iandanforth/rSkin/photos/IMG_20110914_180611.jpg

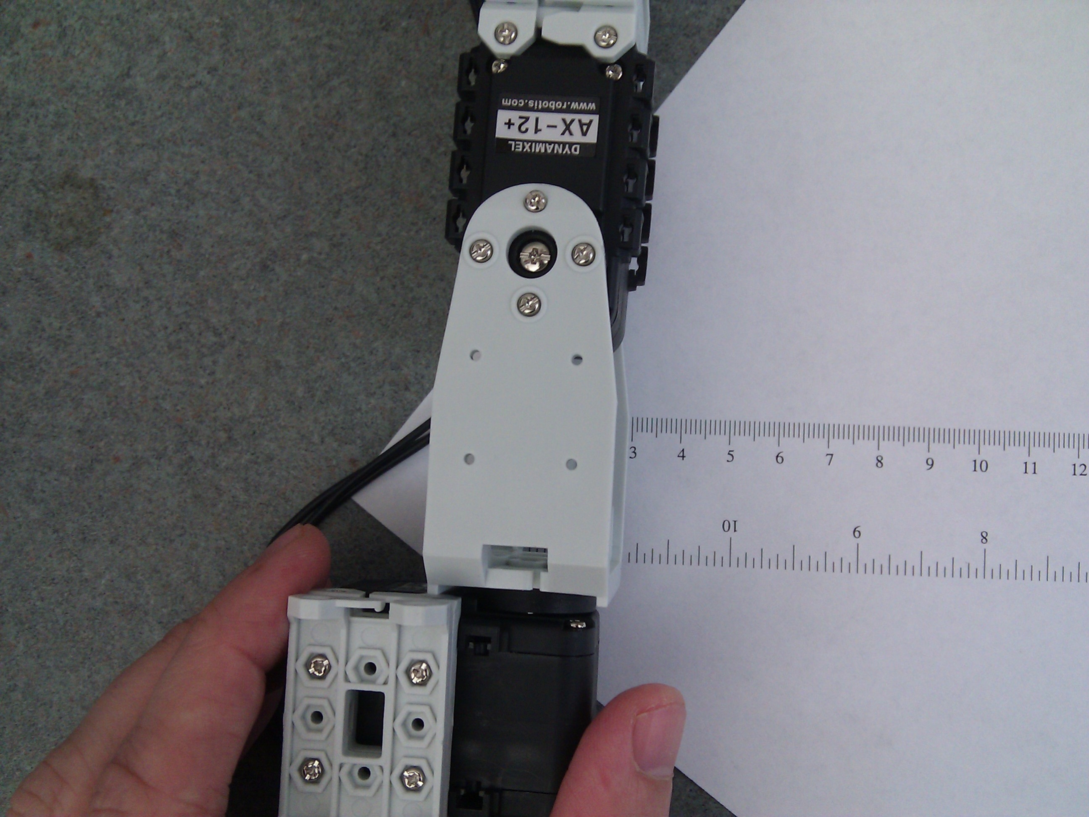
photos/IMG_20110914_180611.jpg
