iandanforth/rSkin/photos/IMG_20110914_180637.jpg

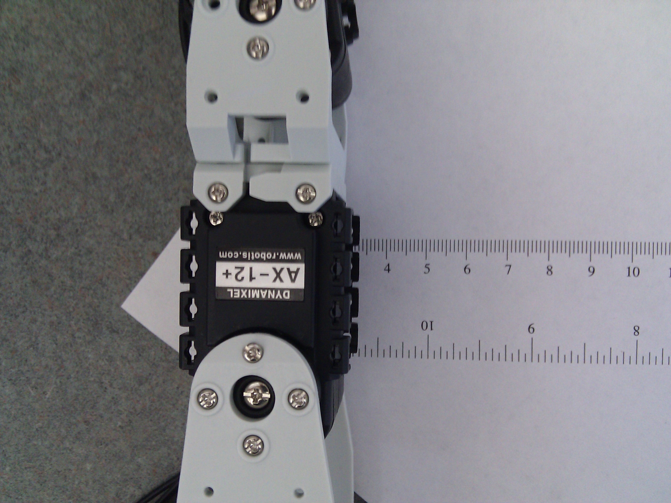
photos/IMG_20110914_180637.jpg
