iandanforth/rSkin/eagle/rSkinBRD.jpg

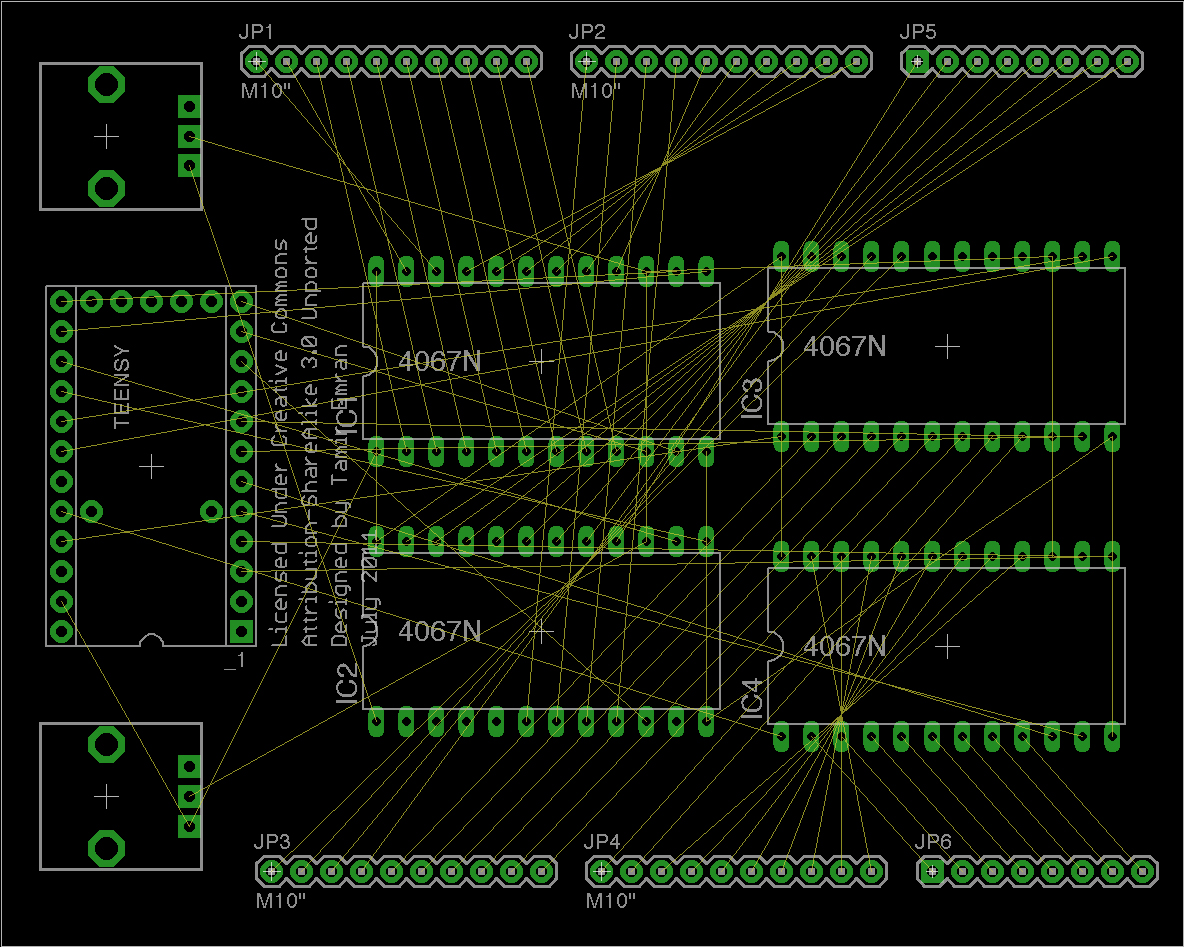
eagle/rSkinBRD.jpg
