iandanforth/rSkin/eagle/rSkinSCH.jpg

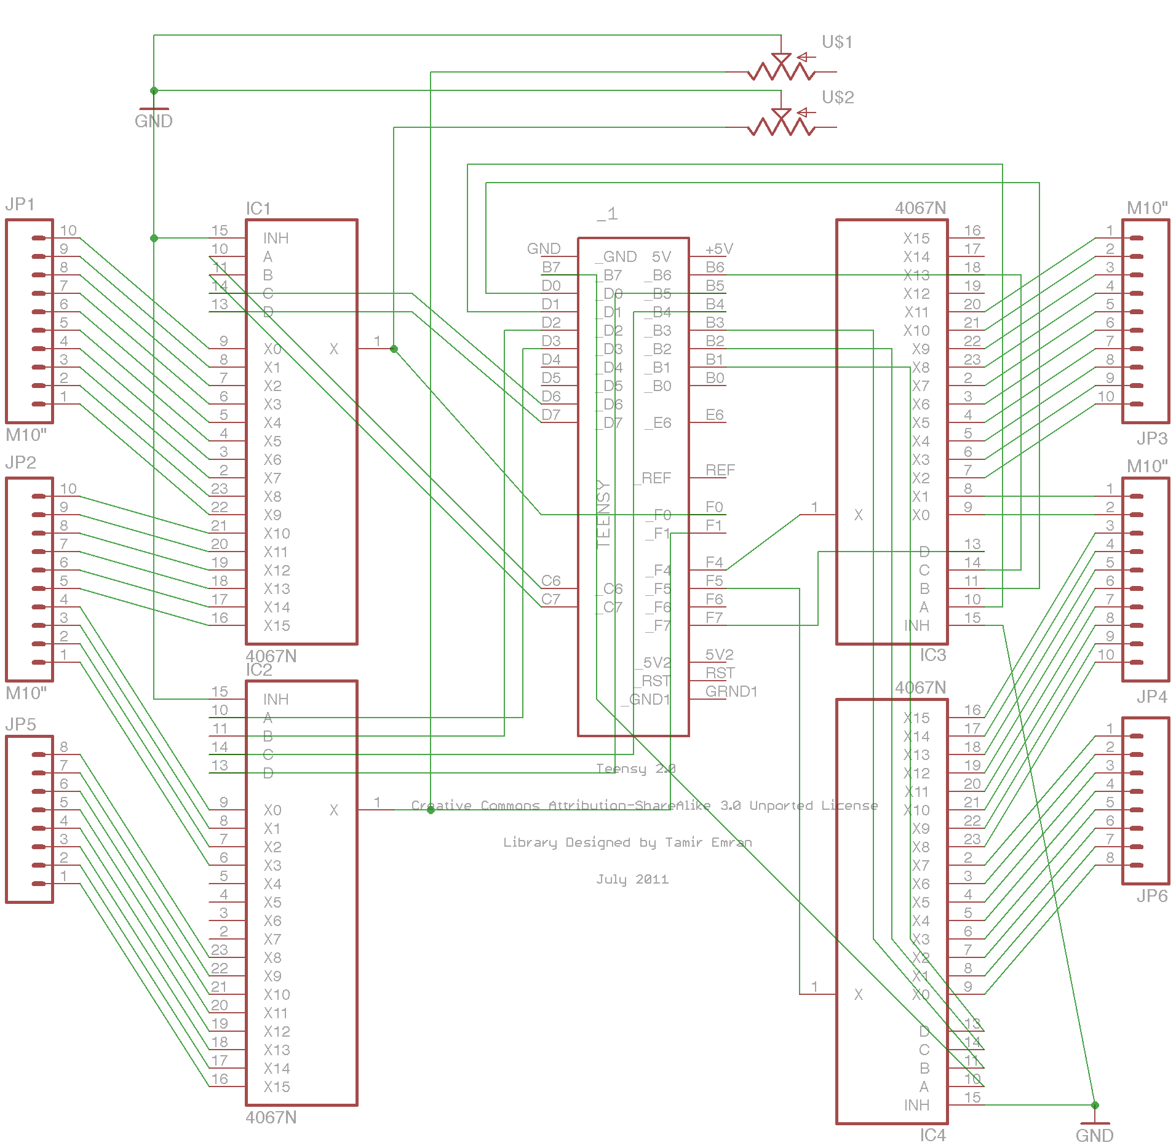
eagle/rSkinSCH.jpg
