iandanforth/rSkin/illustrations/dimensions2.jpg

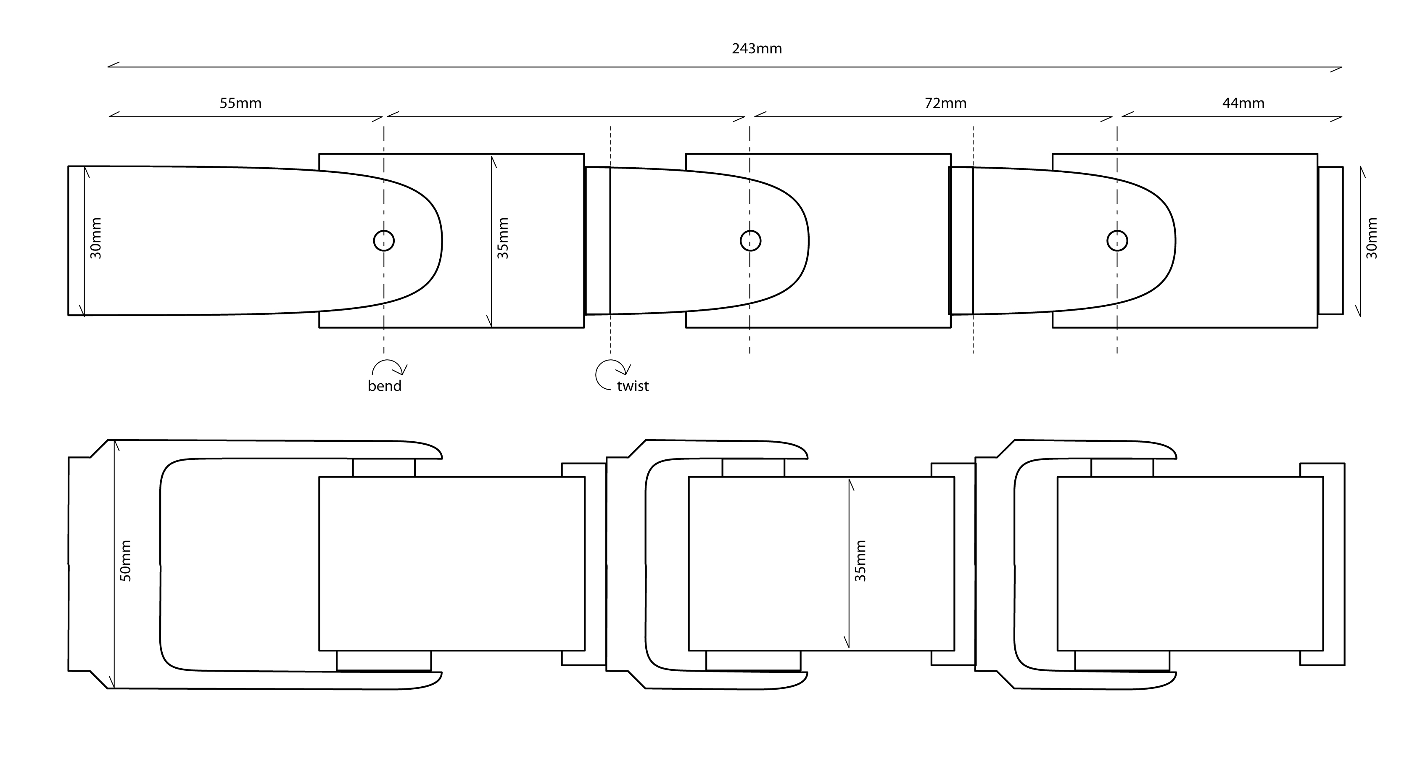
illustrations/dimensions2.jpg
