iandanforth/rSkin/illustrations/dimensions3.jpg

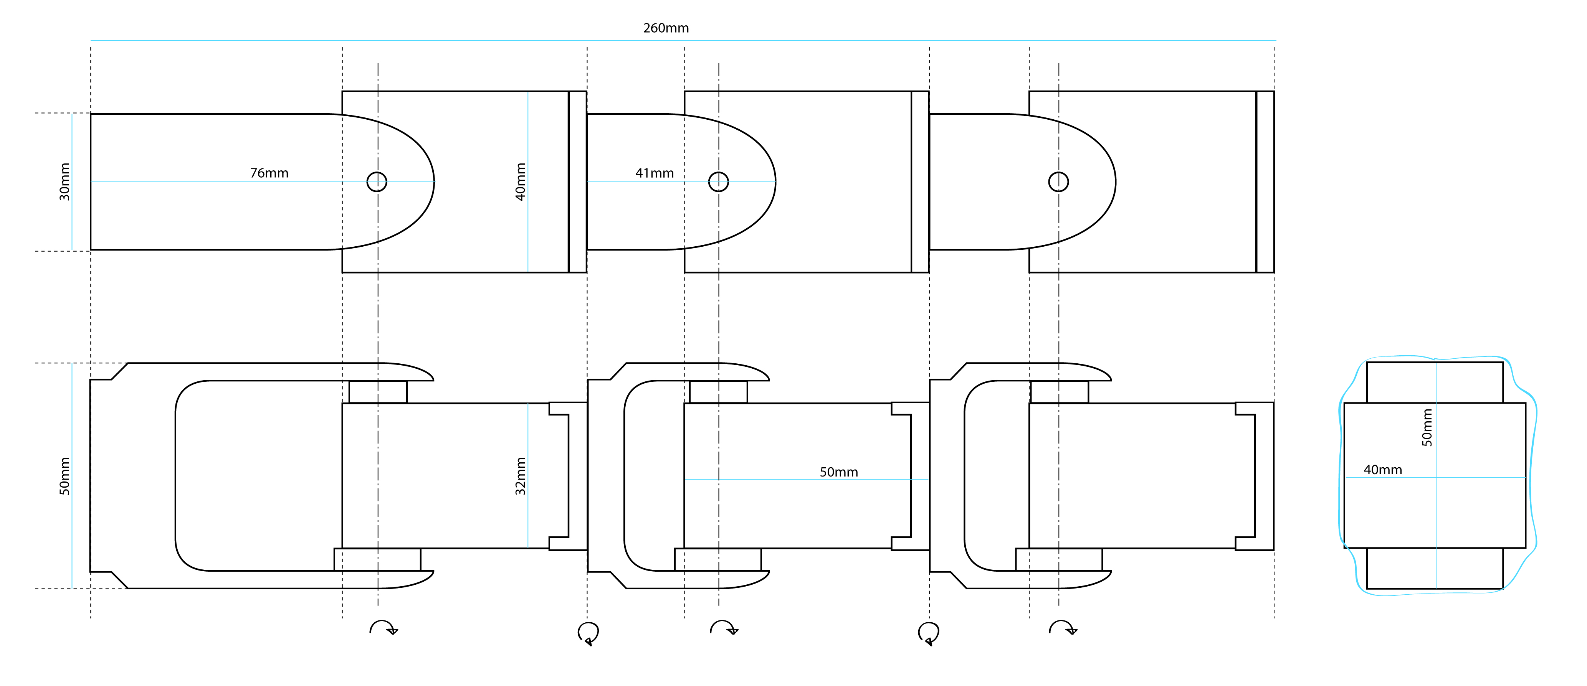
illustrations/dimensions3.jpg
