iandanforth/rSkin/illustrations/dimensions.jpg

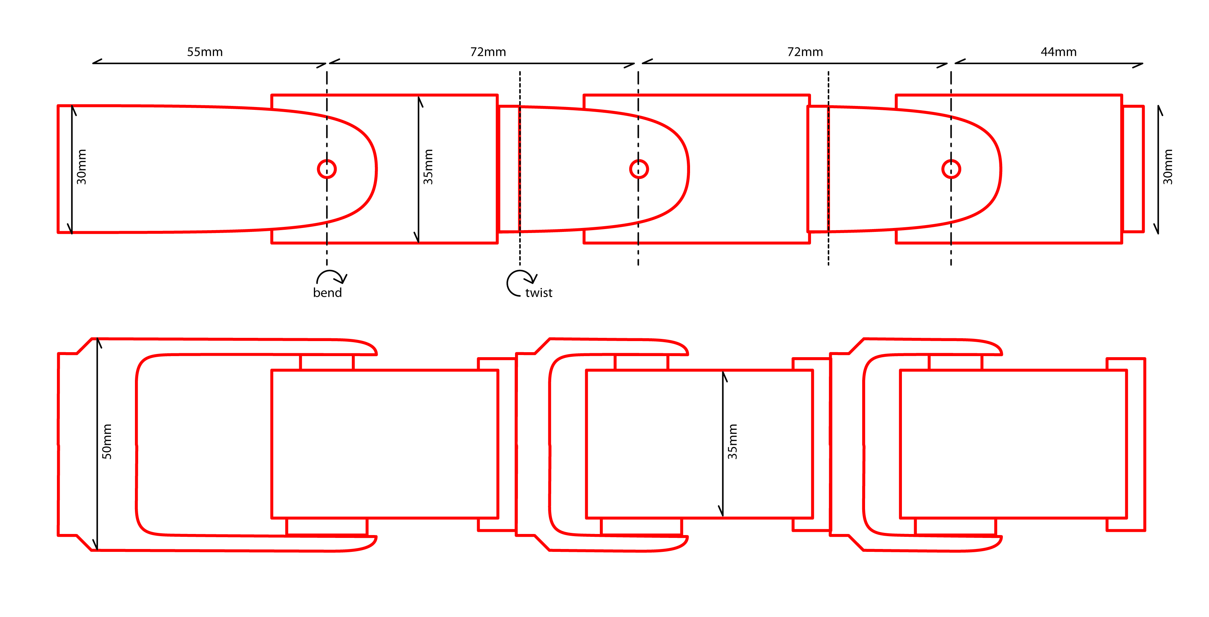
illustrations/dimensions.jpg
