iandanforth/rSkin/illustrations/flesh.jpg

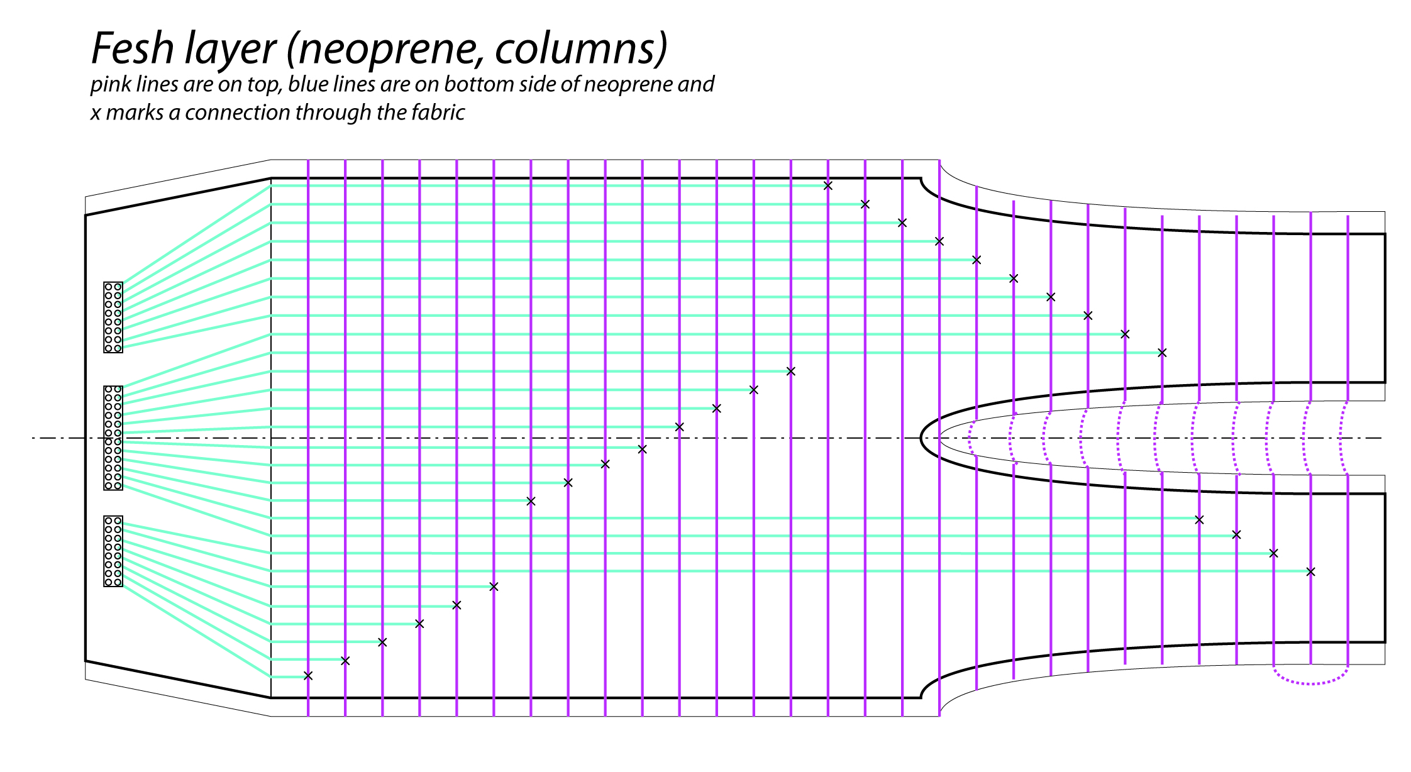
illustrations/flesh.jpg
