iandanforth/rSkin/illustrations/grid.jpg

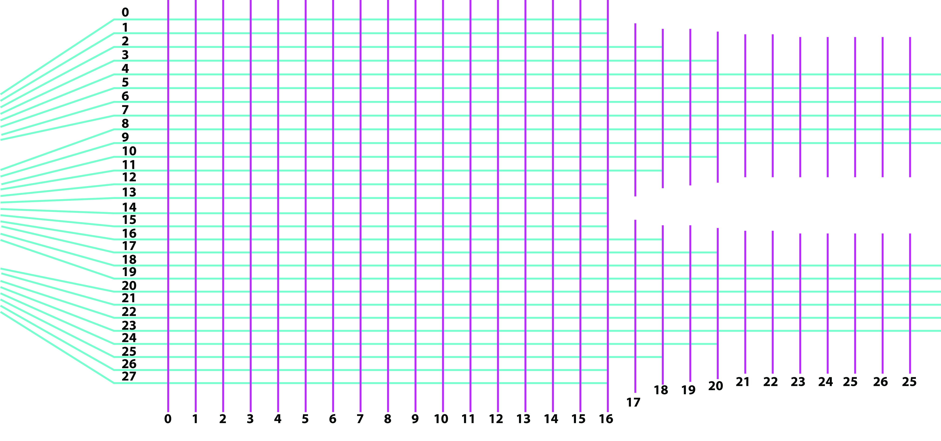
illustrations/grid.jpg
