iandanforth/rSkin/illustrations/laser.jpg

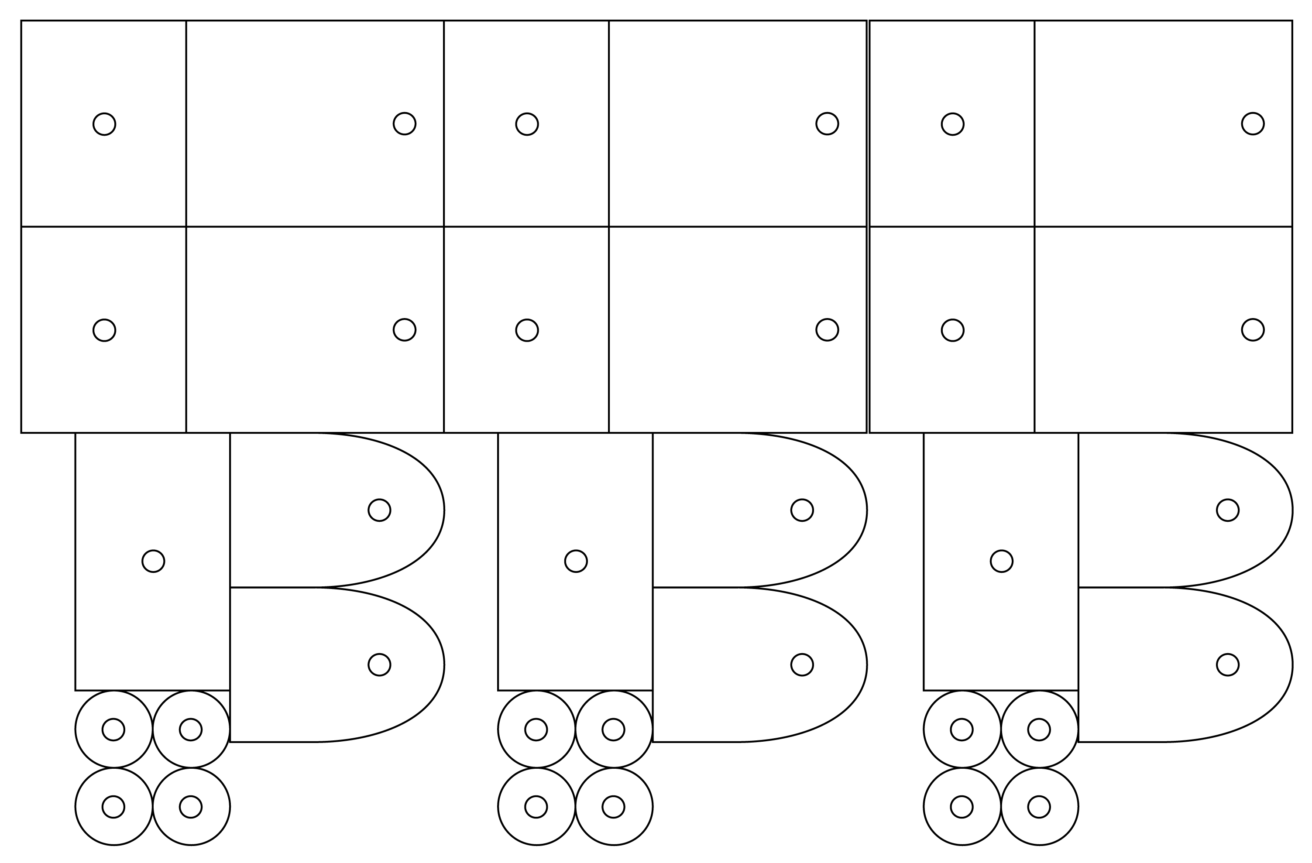
illustrations/laser.jpg
