iandanforth/rSkin/illustrations/layers.jpg

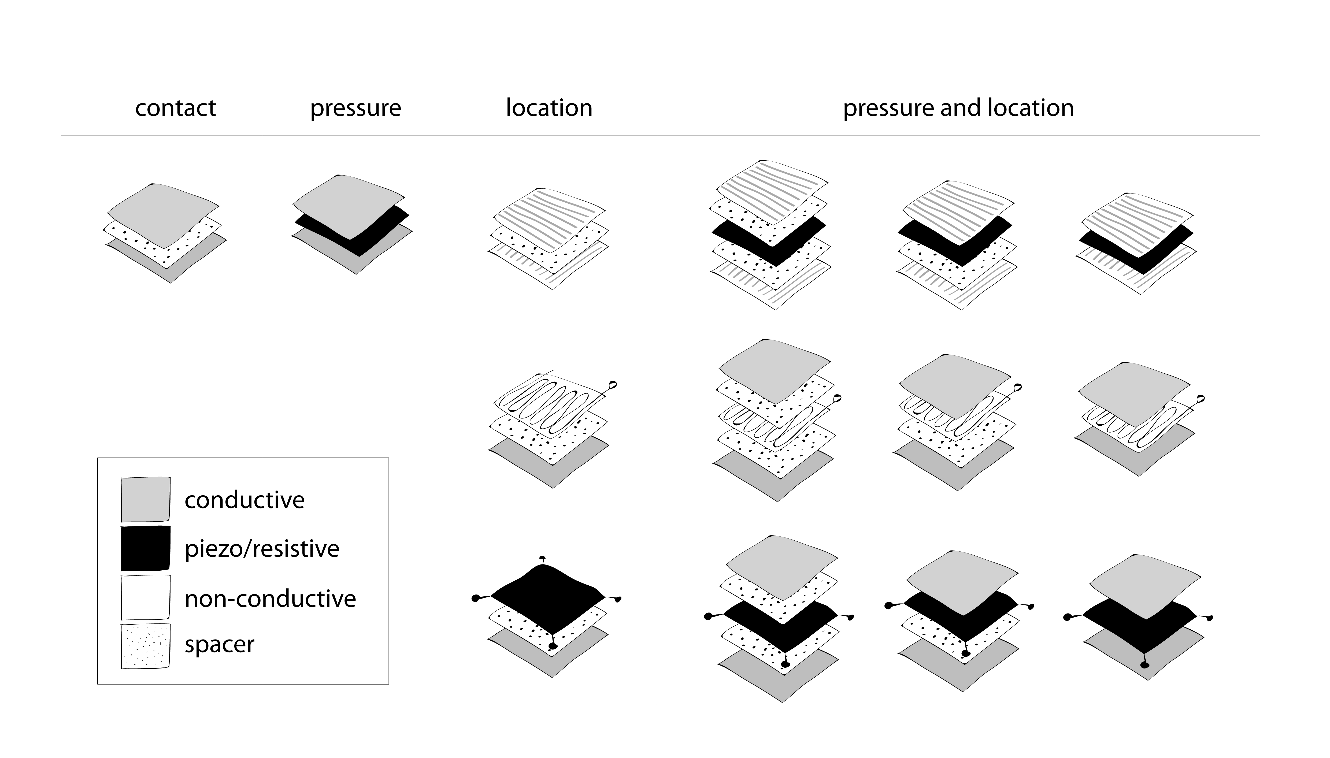
illustrations/layers.jpg
