iandanforth/rSkin/illustrations/resistive-layers.jpg

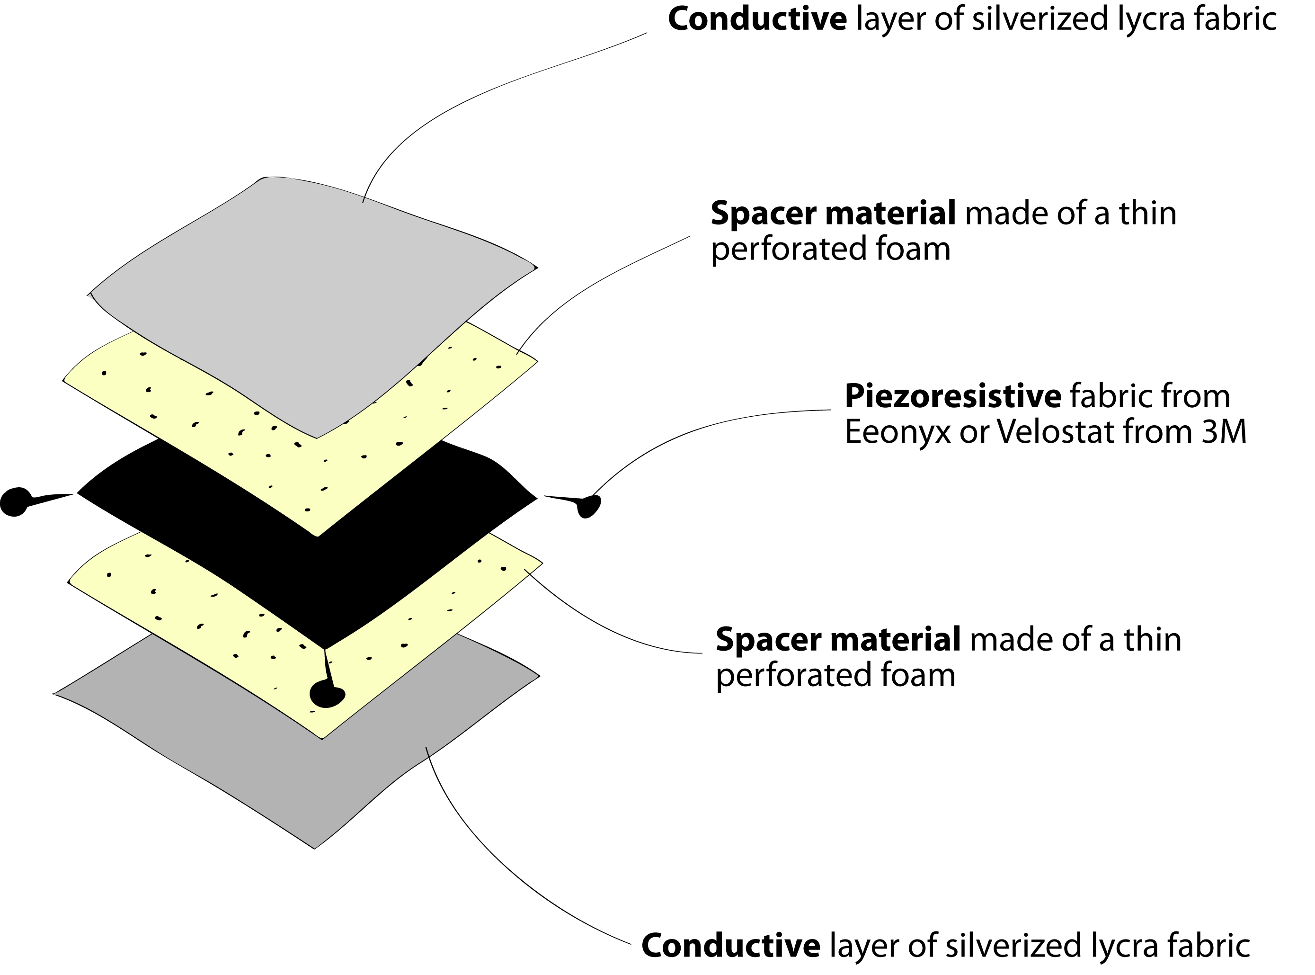
illustrations/resistive-layers.jpg
