iandanforth/rSkin/illustrations/skin.jpg

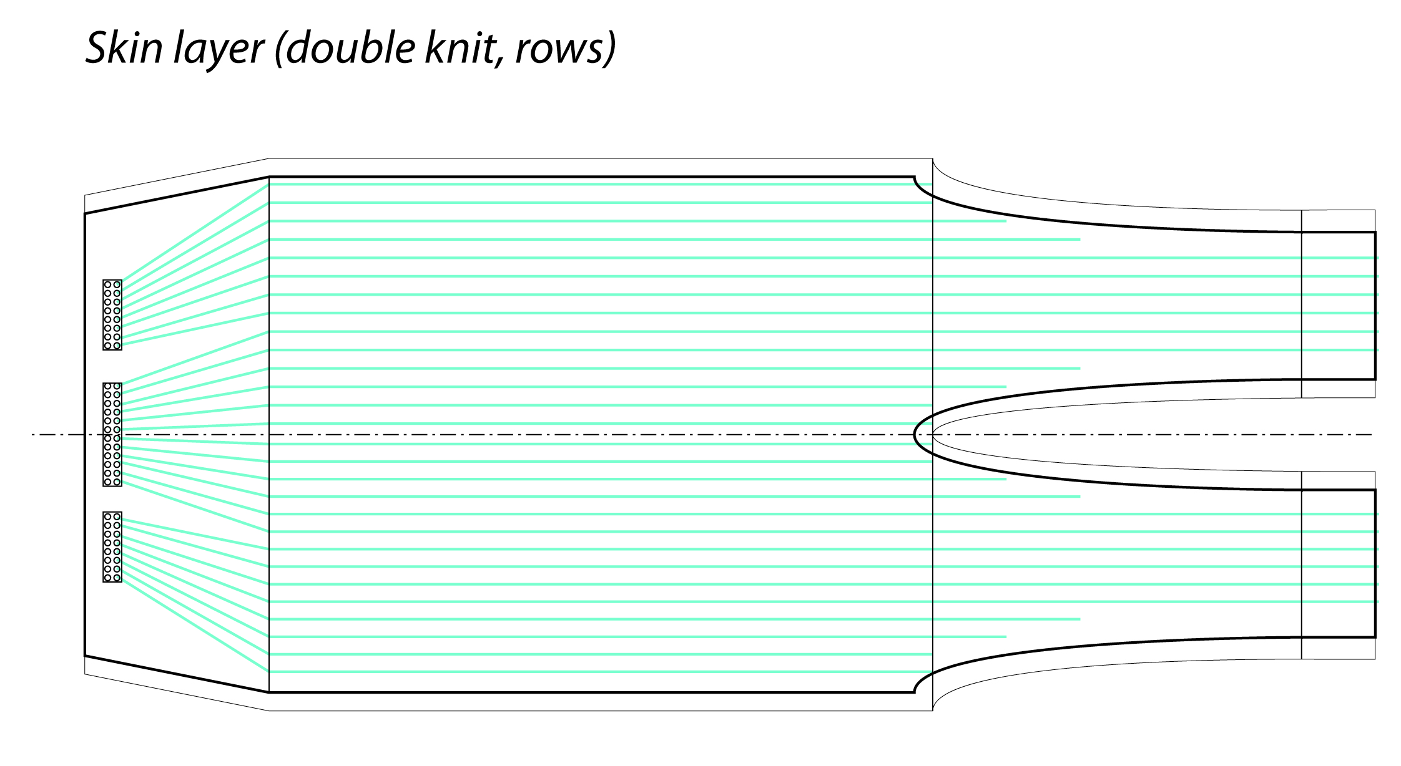
illustrations/skin.jpg
