iandanforth/rSkin/photos/connections.jpg

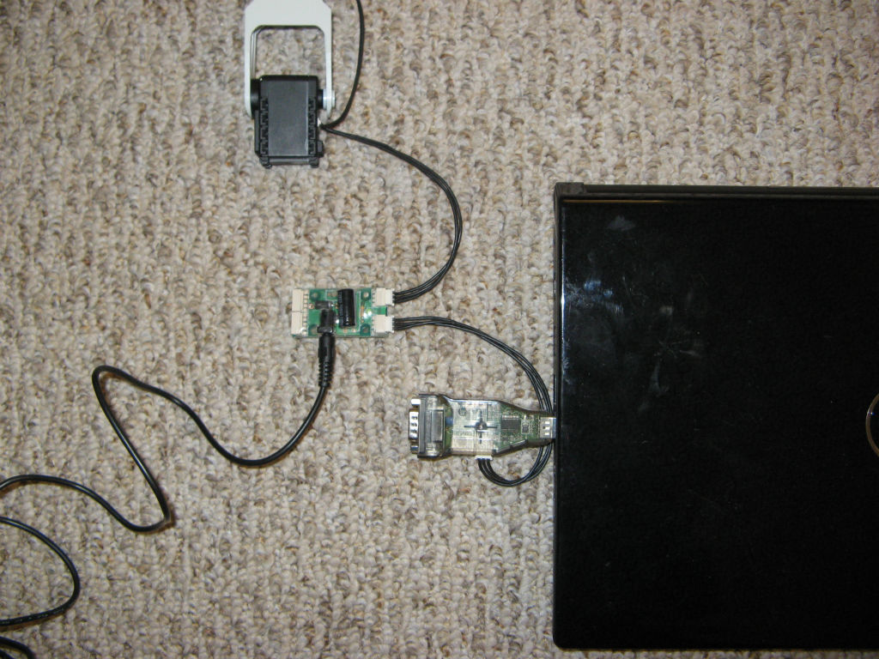
photos/connections.jpg
