iandanforth/rSkin/photos/fixturepoints.png

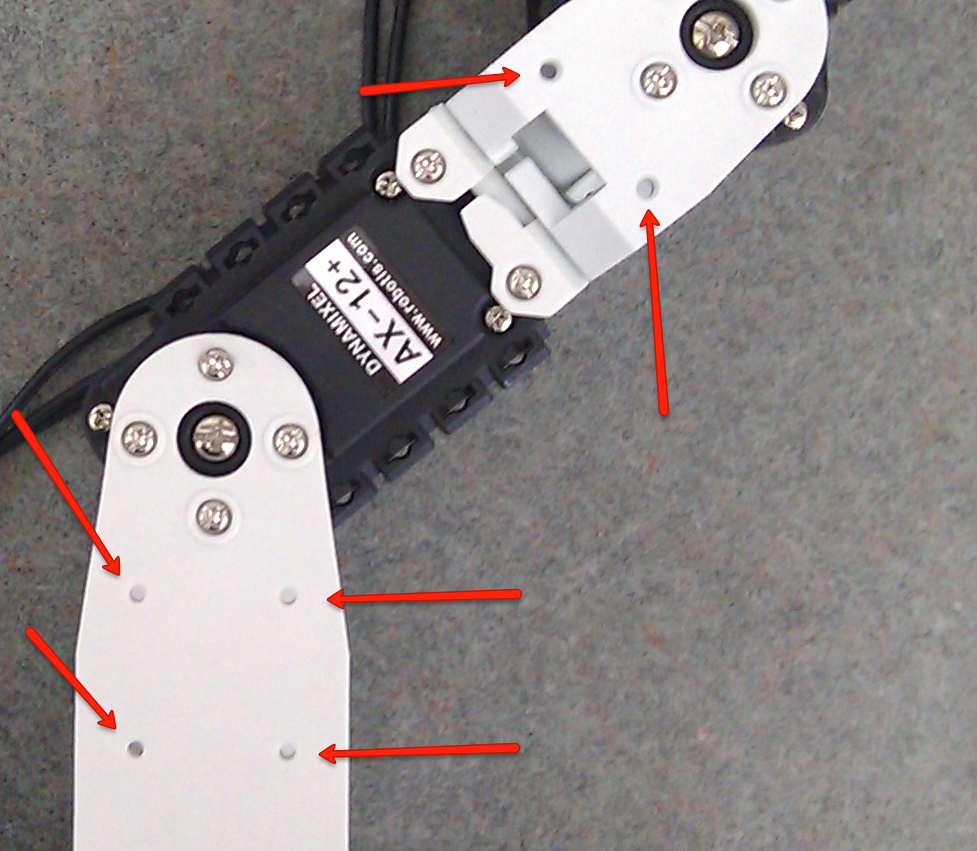
photos/fixturepoints.png
