iandanforth/rSkin/photos/IMG_20110829_172705.jpg

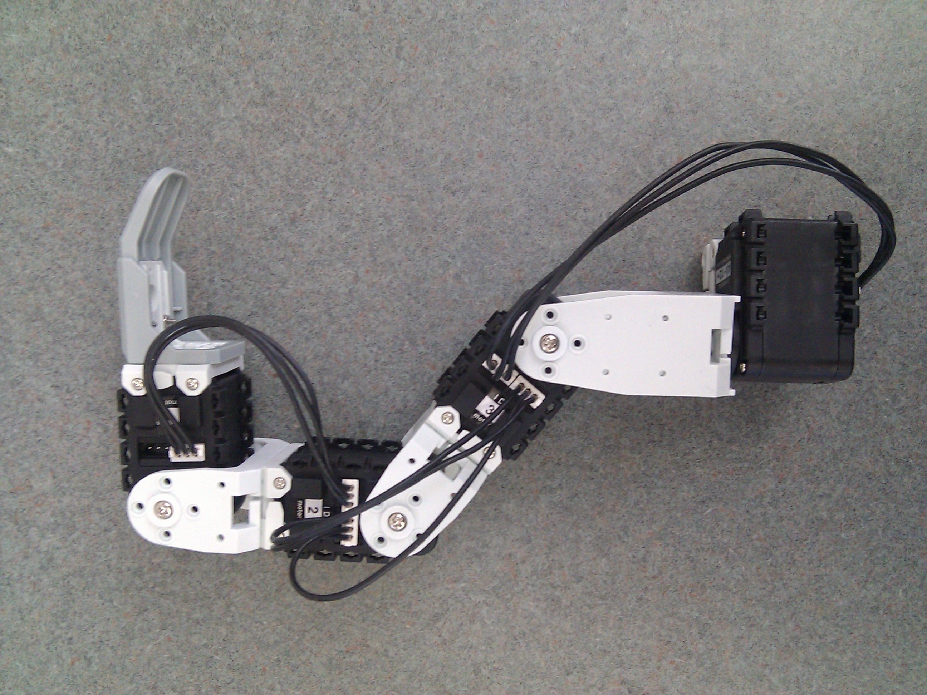
photos/IMG_20110829_172705.jpg
