iandanforth/rSkin/photos/IMG_20110829_172719.jpg

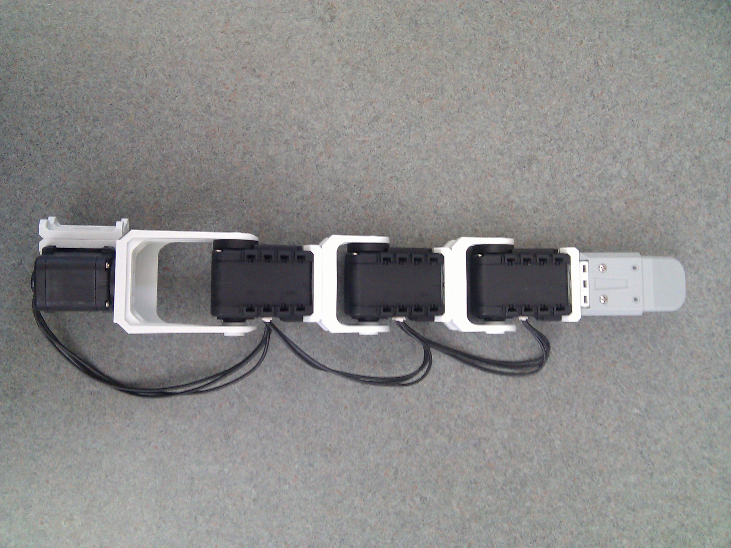
photos/IMG_20110829_172719.jpg
