iandanforth/rSkin/photos/IMG_20110829_172728.jpg

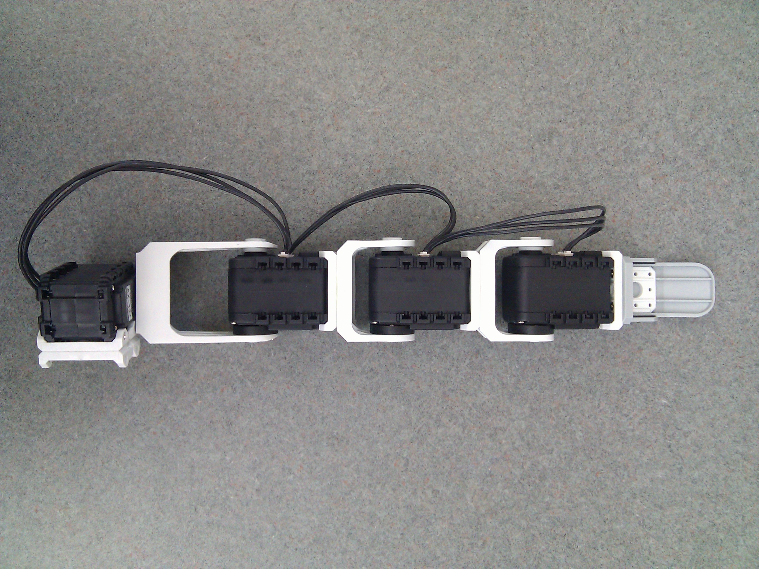
photos/IMG_20110829_172728.jpg
