iandanforth/rSkin/photos/IMG_20110829_172828.jpg

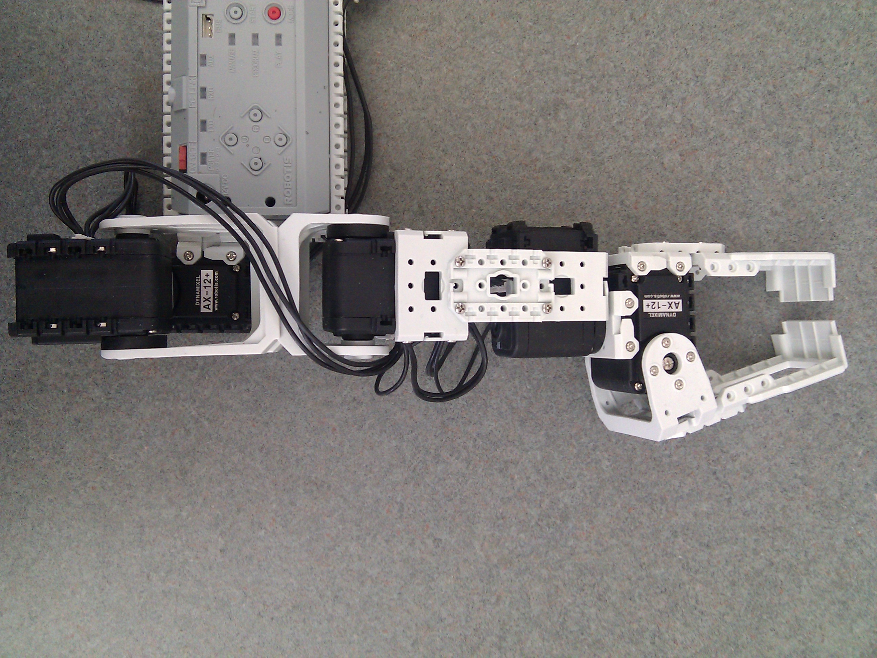
photos/IMG_20110829_172828.jpg
