iandanforth/rSkin/photos/IMG_20110829_172836.jpg

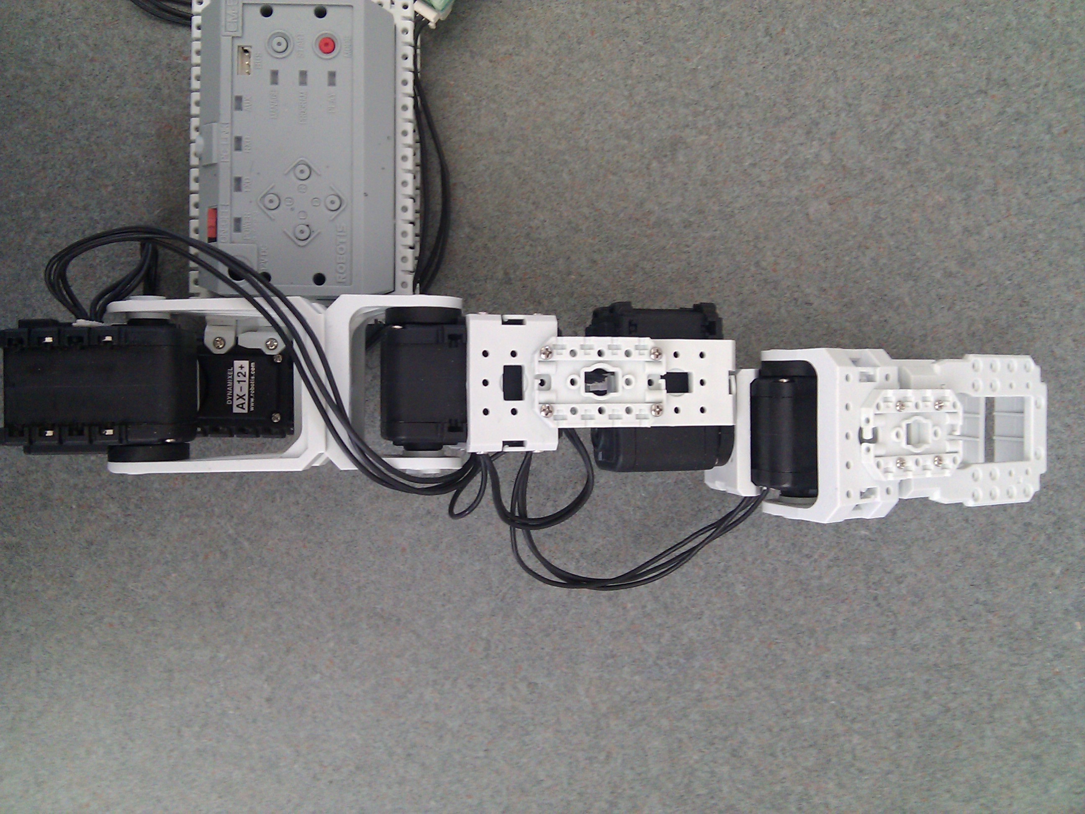
photos/IMG_20110829_172836.jpg
