iandanforth/rSkin/photos/IMG_20110914_180510.jpg

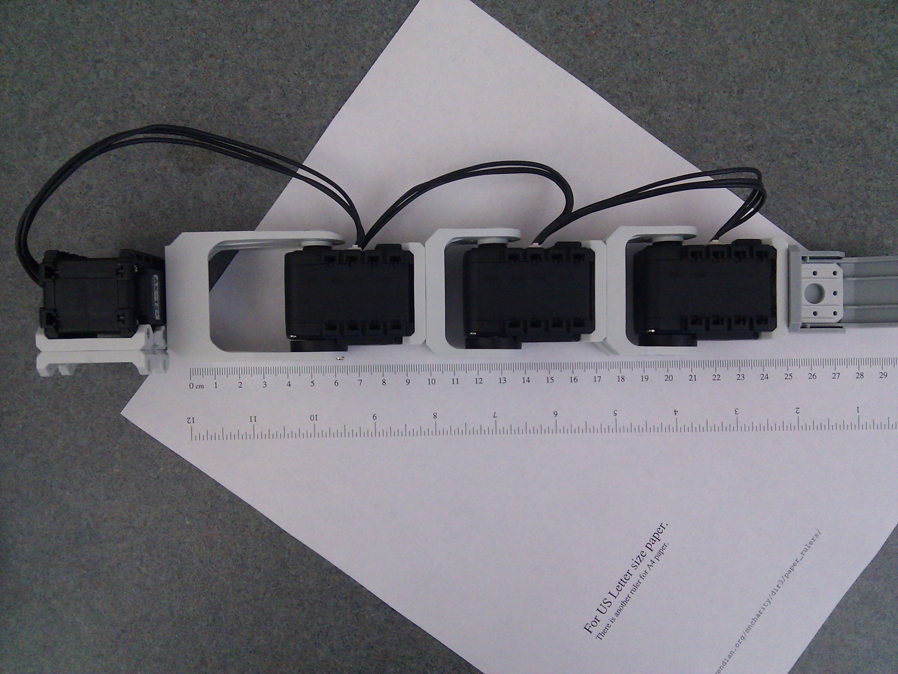
photos/IMG_20110914_180510.jpg
