iandanforth/rSkin/photos/IMG_20110914_180541.jpg

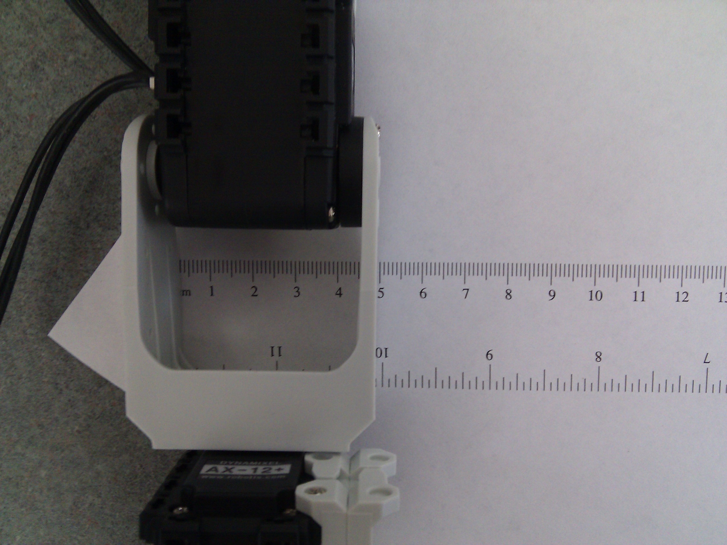
photos/IMG_20110914_180541.jpg
