iandanforth/rSkin/photos/robot-arm.jpg

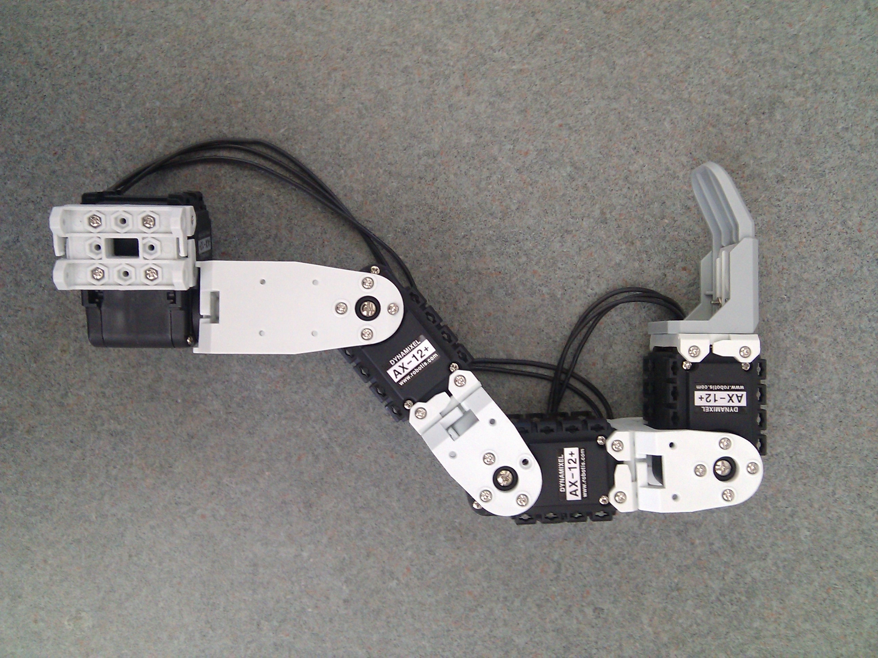
photos/robot-arm.jpg
