iandanforth/rSkin/illustrations/setup.jpg

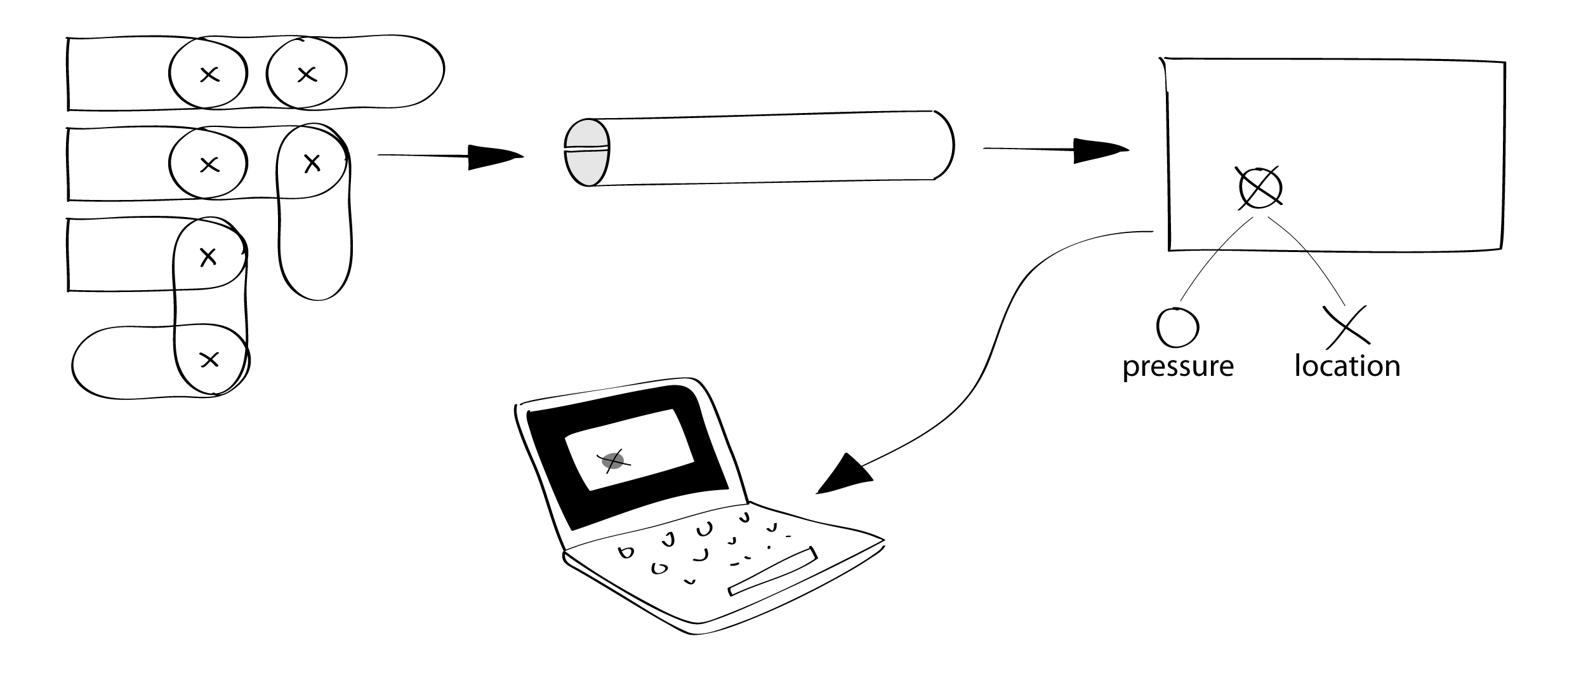
illustrations/setup.jpg
