iandanforth/rSkin/illustrations/measurements.jpg

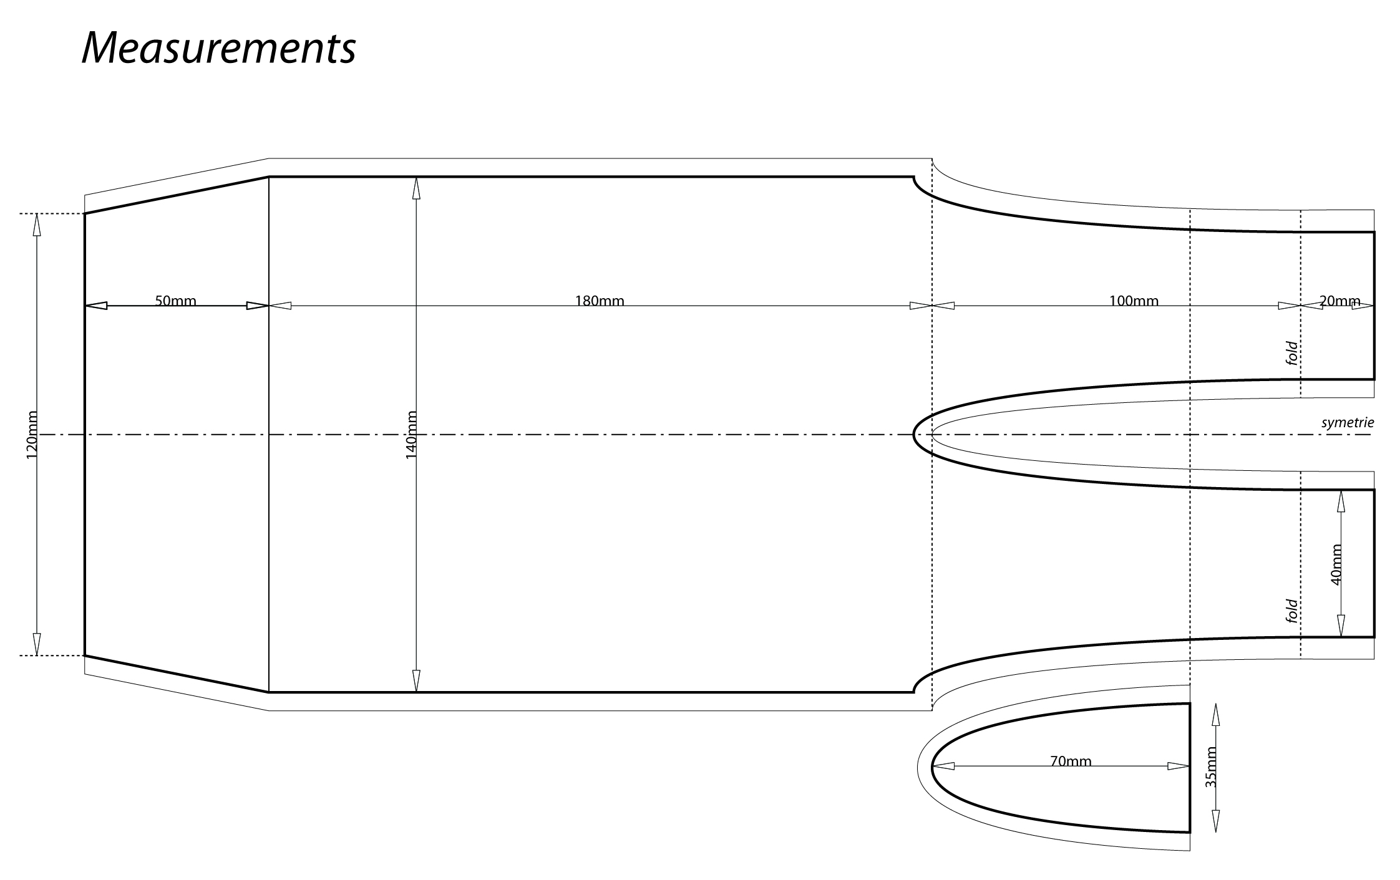
illustrations/measurements.jpg
