iandanforth/rSkin/pdf/rSkinA3.pdf

# Measurements

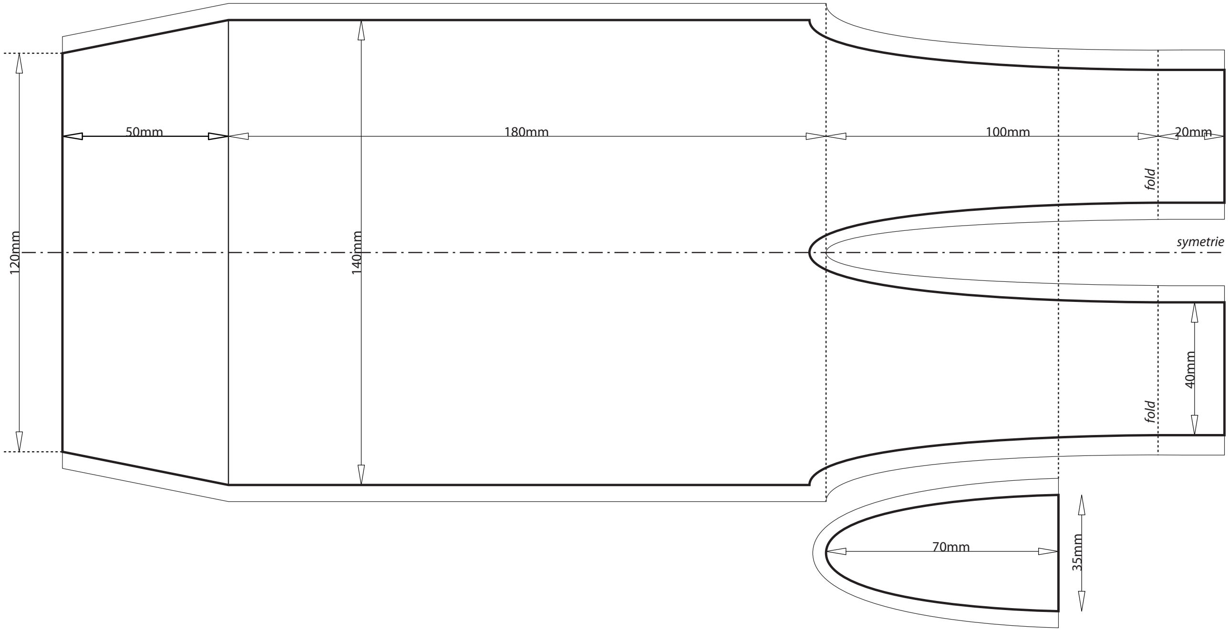
[picture p26: figure]
fold fold; symetrie

# Fesh layer (neoprene, columns)

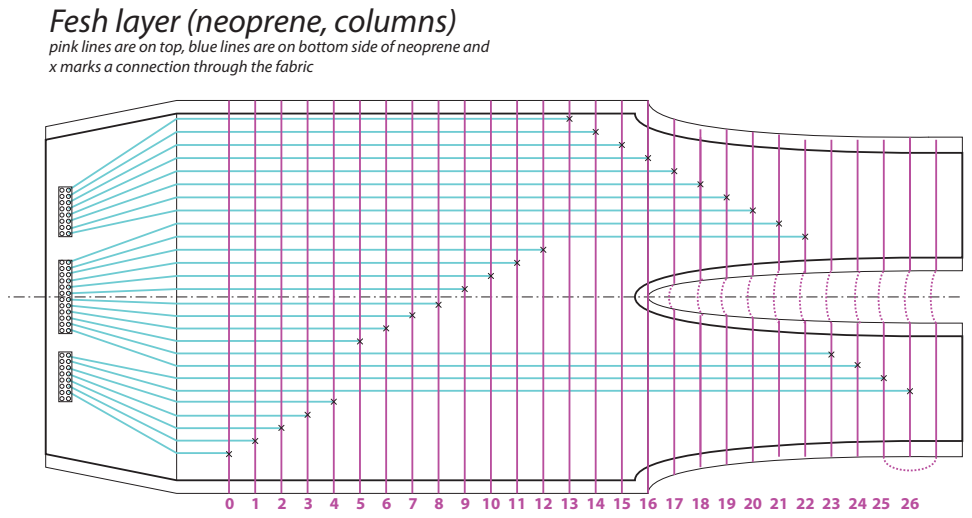
[picture p27: page 2]

pink lines are on top, blue lines are on bottom side of neoprene and
x marks a connection through the fabric

# Skin layer (double knit, rows)

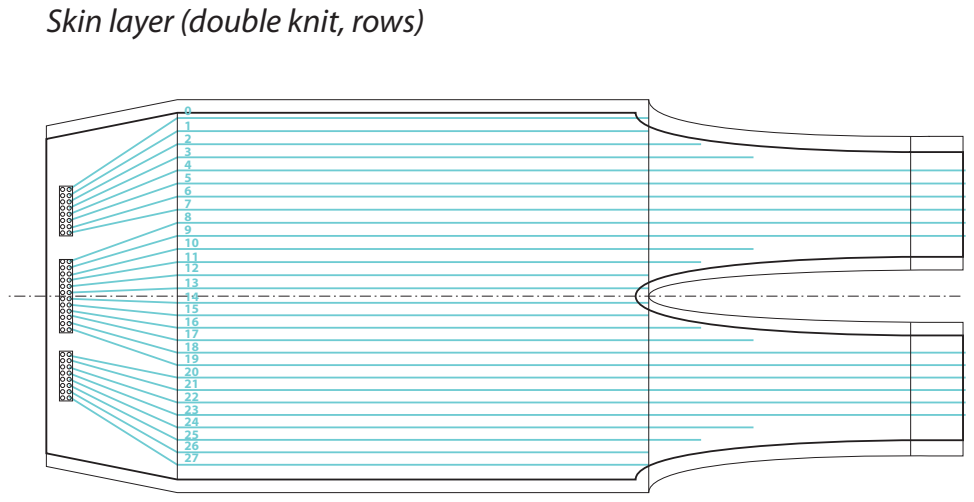
[picture p28: page 3]

0123456789

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
9 10 11 12 13 14 15 16

17

18 19 20 21 22 23 24 25 26 25
