iandanforth/rSkin/vis/heatmap.py

#!/usr/bin/python

# MIT Licensed - http://jjguy.com/heatmap/
Heatmap = [(255, 237, 237),
             (255, 224, 224),
             (255, 209, 209),
             (255, 193, 193),
             (255, 176, 176),
             (255, 159, 159),
             (255, 142, 142),
             (255, 126, 126),
             (255, 110, 110),
             (255, 94, 94),
             (255, 81, 81),
             (255, 67, 67),
             (255, 56, 56),
             (255, 46, 46),
             (255, 37, 37),
             (255, 29, 29),
             (255, 23, 23),
             (255, 18, 18),
             (255, 14, 14),
             (255, 11, 11),
             (255, 8, 8),
             (255, 6, 6),
             (255, 5, 5),
             (255, 3, 3),
             (255, 2, 2),
             (255, 2, 2),
             (255, 1, 1),
             (255, 1, 1),
             (255, 0, 0),
             (255, 0, 0),
             (255, 0, 0),
             (255, 0, 0),
             (255, 0, 0),
             (255, 0, 0),
             (255, 0, 0),
             (255, 0, 0),
             (255, 1, 0),
             (255, 4, 0),
             (255, 6, 0),
             (255, 10, 0),
             (255, 14, 0),
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
