iandanforth/rSkin/(commit log)

2011-11-06 Sample python visualization for rSkin + modified teensy code tests
2011-11-10 added EAGLE file to repository
    [rSkinSchematic.brd, rSkinSchematic.sch]
2011-11-16 uploading updated arduino code for teensy, and processing code for visualization
2011-11-20 rename eagle file that contains circuit schematics and pcb layout
    [rSkinSchematic.brd, rSkinSchematic.sch]
2011-12-28 Python heatmap now working; Add .gitignore
